gpatsiaouras/ford-focus-canbus/(commit log)

2024-02-26 Added docs and arduino code
2024-03-18 Added working code with basic reverse gear camera activation
2024-10-17 Added support for two cameras. Second camera is activated
    by button also decoded a lot of the canbus messages
2024-10-18 Added delay of 10sec to turning off reverse camera
    [ford_focus_canbus.ino]
2025-11-11 Added formula for speed
    - Also added check to turn off camera if more than 20km/h
